OpenComs/docs/analog/devices/apsm1/electronics/BOM_OpenComs_APSM1_2023-05-12.csv

ID | Name | Designator | Footprint | Quantity | Manufacturer Part | Manufacturer | Supplier | Supplier Part | Price
1 | 10u | C30 | C1206 | 1 | CL31A106KBHNNNE | SAMSUNG(三星) | LCSC | C13585 | 0.032
2 | 24V_IN | P1 | CONN-TH_2P-P5.00 | 1 |  |  | LCSC
3 | POWER_SWITCH | P2 | CONN-TH_2P-P5.00 | 1 |  |  | LCSC
4 | 24V_LED | P3 | CONN-TH_2P-P5.00 | 1 |  |  | LCSC
5 | 24V | P4 | CONN-TH_2P-P5.00 | 1 |  |  | LCSC
6 | PL1 | P5 | CONN-TH_3P-P5.00 | 1 |  |  | LCSC
7 | PL2 | P6 | CONN-TH_3P-P5.00 | 1 |  |  | LCSC
8 | TERMINATE_SWITCH | P7 | CONN-TH_2P-P5.00 | 1 |  |  | LCSC
9 | 2.2k | R45 | R0805 | 1 | 0805W8F2201T5E | UNI-ROYAL(厚声) | LCSC | C17520 | 0.002
10 | 200 | R46 | R0805 | 1 | 0805W8F2000T5E | UNI-ROYAL(厚声) | LCSC | C17540 | 0.002
