OpenComs/docs/analog/devices/abp1/electronics/back_panel_jacks/BOM_OpenComs_ABP1_Back-panel_Jacks_2023-05-12.csv

ID | Name | Designator | Footprint | Quantity | Manufacturer Part | Manufacturer | Supplier | Supplier Part | Price
1 | FC68131 | 1,2 | FC68131-5P | 2
