OpenComs/docs/analog/devices/abp1/electronics/front_panel/BOM_OpenComs_ABP1_Front-panel_2023-05-12.csv

ID | Name | Designator | Footprint | Quantity | Manufacturer Part | Manufacturer | Supplier | Supplier Part | Price
1 | 1u | C1,C2,C3,C4,C5,C6,C7,C8 | C0805 | 8 | CL21B105KBFNNNE | SAMSUNG(三星) | LCSC | C28323 | 0.01
2 | WS2812B-4020 | LED1,LED2,LED3,LED4,LED5,LED6,LED7,LED8,LED9,LED10,LED11,LED12,LED13,LED14,LED15,LED16 | LED-SMD_WS2812B-4020 | 16 | WS2812B-4020 | worldsemi | LCSC | C965557 | 0.126
3 | TESTPAD50 | P5,P6,P7 | TESTPAD-50-ROUND | 3
4 | PS6KV50 | RP1 | PS6_POTMETER | 1 | PS6KV50-103A3030-I-PM | PIHER | TME | PS6KV50-103A-I-PM
