OpenComs/docs/analog/devices/abp1/electronics/main_pcb/BOM_OpenComs_ABP1_2023-05-12.csv

ID | Name | Designator | Footprint | Quantity | Manufacturer Part | Manufacturer | Supplier | Supplier Part | Price
1 | 22p | C1,C2 | C0603 | 2 | CL10C220JB8NNNC | SAMSUNG(三星) | LCSC | C1653 | 0.007
2 | 100p | C3 | C0805 | 1 | CL21C101JBANNNC | SAMSUNG(三星) | LCSC | C1790 | 0.01
3 | 820p | C4,C17 | C1206 | 2 | 1206B102K202NT | FH(风华) | LCSC | C9196 | 0.005
4 | 0.47u | C5,C25 | C0805 | 2 | CL21B474KBFNNNE | SAMSUNG(三星) | LCSC | C13967 | 0.014
5 | 1u | C8,C9,C31 | C0603 | 3 | CL10A105KB8NNNC | SAMSUNG(三星) | LCSC | C15849 | 0.005
6 | 100uF | C10 | CAP-SMD_BD8.0-L8.3-W8.3-FD | 1 | RVT1H101M0810 | HONOR(荣誉) | LCSC | C3352 | 0.096
7 | 10uF | C11,C12 | CAP-SMD_L3.2-W1.6-RD-C7171 | 2 | TAJA106K016RNJ | Kyocera AVX | LCSC | C7171 | 0.088
8 | 1u | C14,C19,C28 | C1206 | 3 | CL31B105KBHNNNE | SAMSUNG(三星) | LCSC | C1848 | 0.029
9 | 0.022u | C15,C29 | C0805 | 2 | CL21B223KBANNNC | SAMSUNG(三星) | LCSC | C1729 | 0.01
10 | 0.0047u | C16 | C0805 | 1 | 0805B472K500NT | FH(风华) | LCSC | C1744 | 0.005
11 | 4.7u | C18 | C1206 | 1 | CL21A475KAQNNNE | SAMSUNG(三星) | LCSC | C1779 | 0.011
12 | 0.0022u | C20 | C1206 | 1 | CL21C222JBFNNNE | SAMSUNG(三星) | LCSC | C28260 | 0.036
13 | 0.047u | C21,C23 | C0805 | 2 | CL21B473KBCNNNC | SAMSUNG(三星) | LCSC | C53134 | 0.012
14 | 56p | C22 | C0603 | 1 | CL10C560JB8NNNC | SAMSUNG(三星) | LCSC | C39148 | 0.009
15 | 150p | C24 | C0805 | 1 | 0805B151K500NT | FH(风华) | LCSC | C1716 | 0.005
16 | 39p | C26 | C0805 | 1 | CL21C470JBANNNC | SAMSUNG(三星) | LCSC | C14857 | 0.013
17 | 47u | C27 | C0805 | 1 | CL21A476MQYNNNE | SAMSUNG(三星) | LCSC | C16780 | 0.023
18 | 10u | C30 | C1206 | 1 | CL31A106KBHNNNE | SAMSUNG(三星) | LCSC | C13585 | 0.032
19 | 1N4148W | D1,D2,D4,D5 | SOD-123FL_L2.6-W1.6-LS3.4-RD | 4 | 1N4148W | Tak Cheong | LCSC | C129216 | 0.02
20 | SS210 | D3 | SMA_L4.3-W2.6-LS5.2-RD | 1 | SS210 | MDD | LCSC | C14996 | 0.026
21 | 68uH | L2 | IND-SMD_L6.0-W6.0_SWRH5D | 1 | YNR6028-680M | YJYCOIN(益嘉源) | LCSC | C497832 | 0.075
22 | FC-2012HRK-620D | LED1 | LED0805-RD_RED | 1 | NCD0805R1 | 国星光电 | LCSC | C84256 | 0.011
23 | 2N7002 | Q1 | SOT-23-3_L2.9-W1.3-P1.90-LS2.4-BR | 1 | 2N7002 | CJ(江苏长电/长晶) | LCSC | C8545 | 0.016
24 | SS8050 | Q2,Q4,Q6,Q7,Q9 | SOT-23-3_L2.9-W1.3-P1.90-LS2.4-BR | 5 | SS8050 | CJ(江苏长电/长晶) | LCSC | C2150 | 0.015
25 | MMBT5401 | Q3 | SOT-23-3_L2.9-W1.3-P1.90-LS2.4-BR | 1 | MMBT5401 | CJ(江苏长电/长晶) | LCSC | C8326 | 0.015
26 | 22 | R1,R25 | R1206 | 2 | 1206W4F220JT5E | UNI-ROYAL(厚声) | LCSC | C17958 | 0.003
27 | 220k | R2,R3,R8,R22 | R0805 | 4 | 0805W8F2203T5E | UNI-ROYAL(厚声) | LCSC | C17556 | 0.002
28 | 47k | R4,R16,R17,R20,R31 | R0805 | 5 | 0805W8F4702T5E | UNI-ROYAL(厚声) | LCSC | C17713 | 0.002
29 | 1k | R5,R36 | R1206 | 2 | 1206W4F1001T5E | UNI-ROYAL(厚声) | LCSC | C4410 | 0.003
30 | 15k | R6,R11,R21 | R0805 | 3 | 0805W8F1502T5E | UNI-ROYAL(厚声) | LCSC | C17475 | 0.002
31 | 100k | R7,R33 | R1206 | 2 | 1206W4F1003T5E | UNI-ROYAL(厚声) | LCSC | C17900 | 0.003
32 | 10k | R9,R34,R41,R43,R51 | R1206 | 5 | 1206W4F1002T5E | UNI-ROYAL(厚声) | LCSC | C17902 | 0.003
33 | 2.7k | R10,R29 | R0805 | 2 | 0805W8F2701T5E |  | LCSC
34 | 6.8k | R12 | R0805 | 1 | 0805W8F6801T5E | UNI-ROYAL(厚声) | LCSC | C17772 | 0.002
35 | 20k | R13,R14 | R0805 | 2 | 0805W8F2002T5E | UNI-ROYAL(厚声) | LCSC | C4328 | 0.001
36 | 430 | R15 | R0805 | 1 | 0805W8F4700T5E | UNI-ROYAL(厚声) | LCSC | C17710 | 0.002
37 | 2.2k | R18,R45 | R0805 | 2 | 0805W8F2201T5E | UNI-ROYAL(厚声) | LCSC | C17520 | 0.002
38 | 120k | R19 | R0805 | 1 | 0805W8F1203T5E | UNI-ROYAL(厚声) | LCSC | C17436 | 0.002
39 | 5.6k | R23 | R0805 | 1 | 0805W8F5601T5E | UNI-ROYAL(厚声) | LCSC | C4382 | 0.002
40 | 150k | R24 | R0805 | 1 | 0805W8F1503T5E | UNI-ROYAL(厚声) | LCSC | C17470 | 0.002
41 | 39 | R26 | R0805 | 1 | 0805W8F330JT5E | UNI-ROYAL(厚声) | LCSC | C17634 | 0.002
42 | 330k | R30,R38 | R0805 | 2 | 0805W8F3303T5E | UNI-ROYAL(厚声) | LCSC | C17629 | 0.002
43 | 4.7k | R32,R44,R47 | R1206 | 3 | 1206W4F4701T5E | UNI-ROYAL(厚声) | LCSC | C17936 | 0.003
44 | 470k | R35,R40 | R0805 | 2 | 0805W8F4703T5E | UNI-ROYAL(厚声) | LCSC | C17709 | 0.002
45 | 150 | R37 | R0805 | 1 | 0805W8F1500T5E | UNI-ROYAL(厚声) | LCSC | C17471 | 0.002
46 | 10M | R39 | R0805 | 1 | 0805W8F1005T5E | UNI-ROYAL(厚声) | LCSC | C26108 | 0.002
47 | 200 | R46 | R0805 | 1 | 0805W8F2000T5E | UNI-ROYAL(厚声) | LCSC | C17540 | 0.002
48 | XL1509-5.0E1 | U3 | SOIC-8_L5.0-W4.0-P1.27-LS6.0-BL | 1 | XL1509-5.0E1 | XLSEMI(芯龙) | LCSC | C61063 | 0.22
49 | ATMEGA328P-AU | U6 | TQFP-32_L7.0-W7.0-P0.80-LS9.0-BL | 1 | ATMEGA328P-AU | MICROCHIP(美国微芯) | LCSC | C14877 | 2.52
50 | 16MHz | X1 | OSC-SMD_4P-L3.2-W2.5-BL | 1 | X322516MLB4SI | YXC(扬兴晶振) | LCSC | C13738 | 0.076
51 | NE5532DR | U1,U2,U4,U5 | SOIC-8_L4.9-W3.9-P1.27-LS6.0-BL | 4 | NE5532DR | TI(德州仪器) | LCSC | C7426 | 0.267
