OpenComs/docs/analog/devices/aps1/3d/Assem1.SLDASM

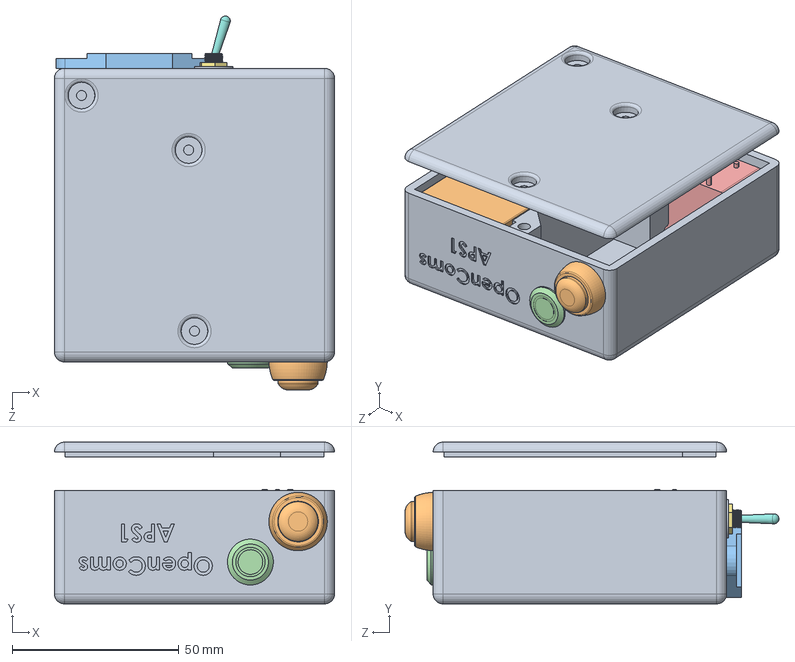
[picture p1: CAD file, 2023-05-15]
analog/devices/aps1/3d/Assem1.SLDASM
84.0 x 48.5 x 112.1 mm
base
Hi-Link HiLink HLK-PM
IEC-C4-3pins
FlatButton
3-D NC3MAH.stp
toggle_mts_1_base_thread
toggle_mts_1_nut
toggle_mts_1_lever
toggle_mts_1_washer
Button PBS-33^Push Button Switch PBS-33B - blue
Nut^Push Button Switch PBS-33B - blue
