OpenComs/docs/analog/devices/abp1/3d/back_panel.SLDASM

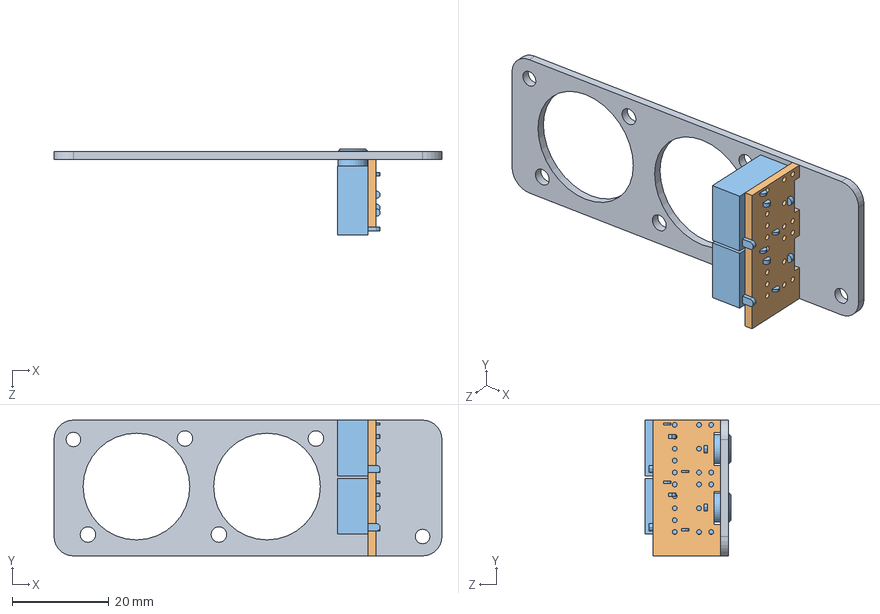
[picture p2: CAD file, 2023-05-15]
analog/devices/abp1/3d/back_panel.SLDASM
80.0 x 28.0 x 17.7 mm
back_panel_pcb
back_panel_jack_pcb
Jack 3_5 mm TRS femaile x 2
