OpenComs/docs/analog/devices/abp1/3d/front_panel.SLDASM

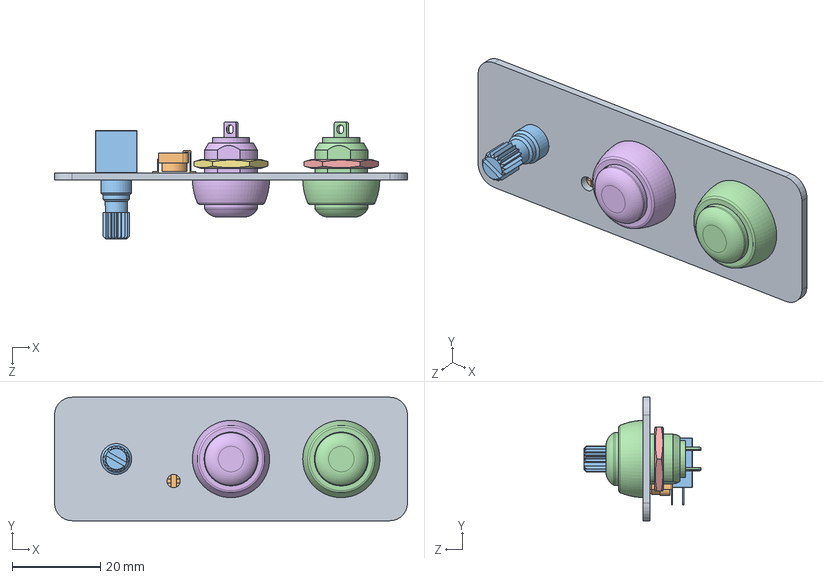
[picture p3: CAD file, 2023-05-15]
analog/devices/abp1/3d/front_panel.SLDASM
80.0 x 28.0 x 26.6 mm
front_panel_pcb
Pot - RES_VAR1
PTD902-2015F-A103
Button PBS-33^Push Button Switch PBS-33B - red
Nut^Push Button Switch PBS-33B - red
Button PBS-33^Push Button Switch PBS-33B - green
Nut^Push Button Switch PBS-33B - green
