OpenComs/docs/analog/devices/abp1/3d/pcb_assembly.SLDASM

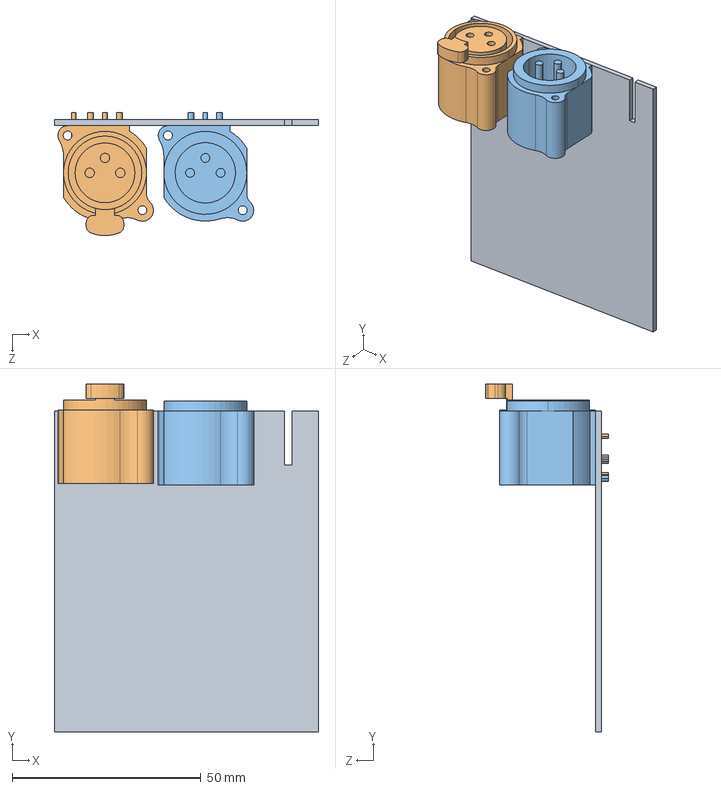
[picture p4: CAD file, 2023-05-15]
analog/devices/abp1/3d/pcb_assembly.SLDASM
70.0 x 92.2 x 32.6 mm
pcb
3-d-nc3faah2.stp
3-D NC3MAH.stp
