OpenComs/docs/analog/devices/abp1/3d/assembly.SLDASM

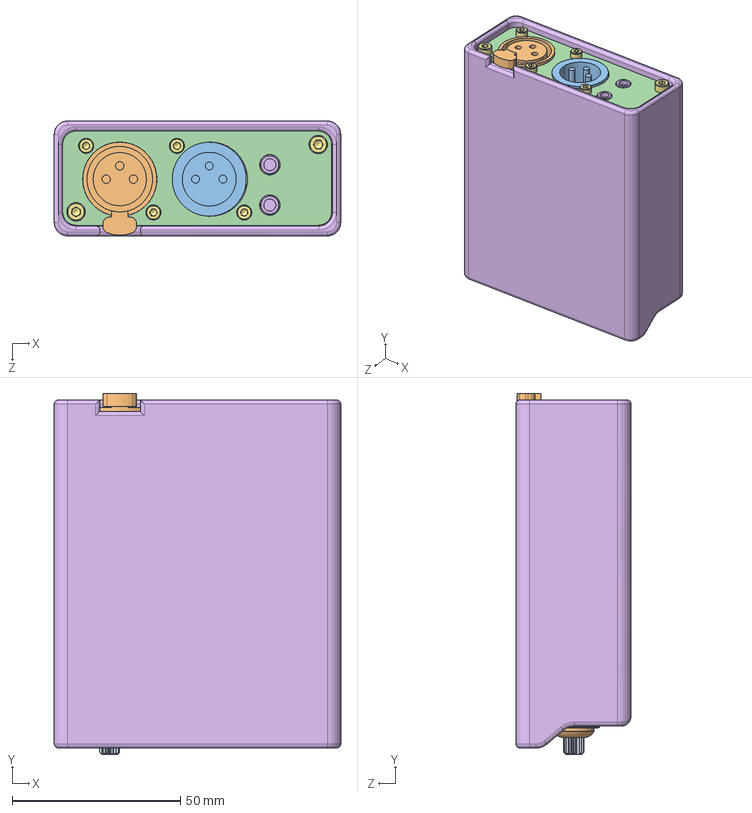
[picture p5: CAD file, 2023-05-15]
analog/devices/abp1/3d/assembly.SLDASM
85.2 x 107.3 x 34.2 mm
pcb
3-d-nc3faah2.stp
3-D NC3MAH.stp
back_panel_pcb
back_panel_jack_pcb
Jack 3_5 mm TRS femaile x 2
front_panel_pcb
Pot - RES_VAR1
PTD902-2015F-A103
Button PBS-33^Push Button Switch PBS-33B - red
Nut^Push Button Switch PBS-33B - red
Button PBS-33^Push Button Switch PBS-33B - green
Nut^Push Button Switch PBS-33B - green
case
socket head cap screw_am x 6
