OpenComs/docs/analog/devices/abp1/3d/back_panel_pcb.SLDPRT

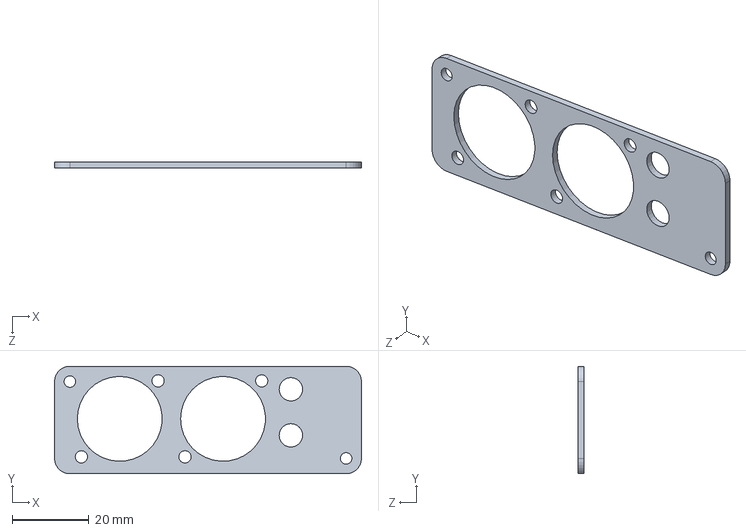
[picture p6: CAD file, 2023-05-15]
analog/devices/abp1/3d/back_panel_pcb.SLDPRT
80.0 x 28.0 x 1.60 mm
