OpenComs/docs/analog/devices/aps1/3d/case.SLDPRT

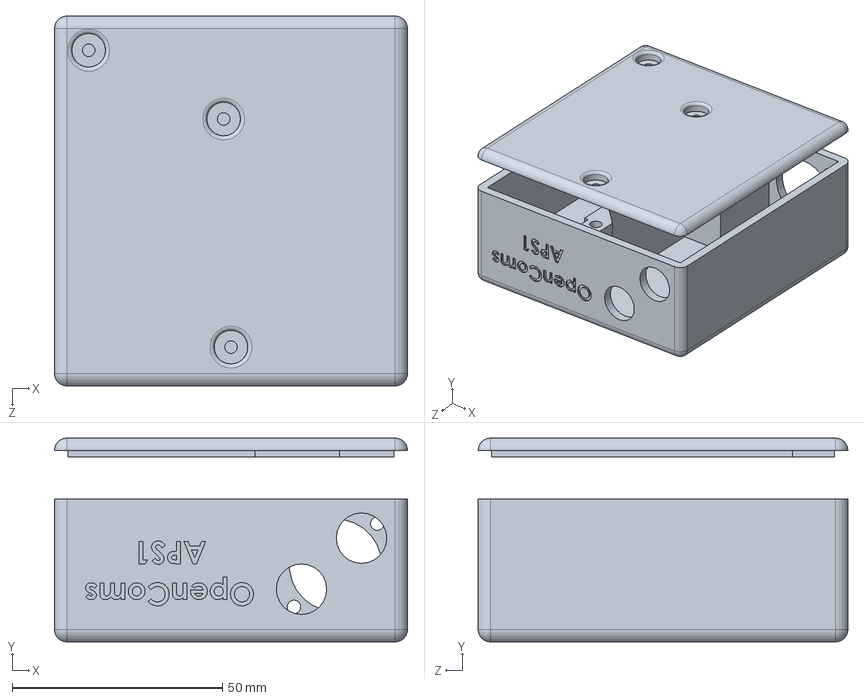
[picture p7: CAD file, 2023-05-15]
analog/devices/aps1/3d/case.SLDPRT
84.0 x 48.5 x 88.0 mm
