OpenComs/docs/analog/devices/abp1/3d/pcb.SLDPRT

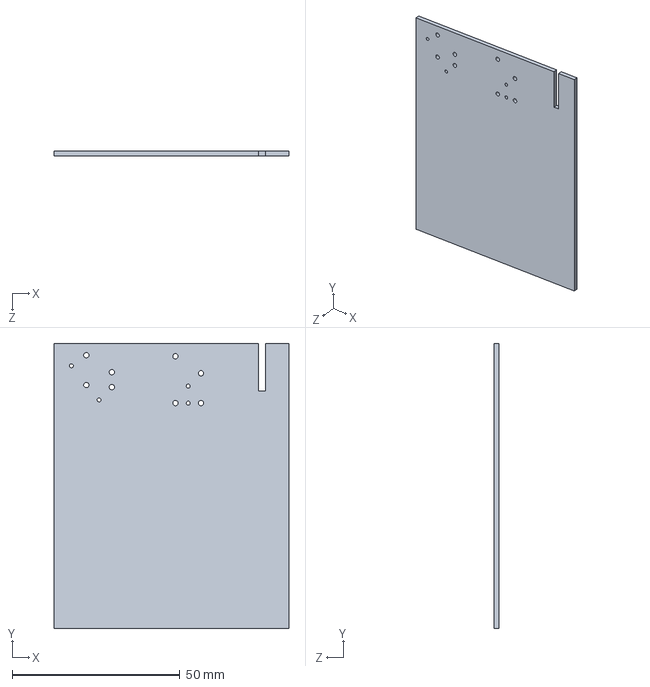
[picture p8: CAD file, 2023-05-15]
analog/devices/abp1/3d/pcb.SLDPRT
70.0 x 85.0 x 1.60 mm
