OpenComs/docs/analog/devices/aps1/3d/case_cover.STL

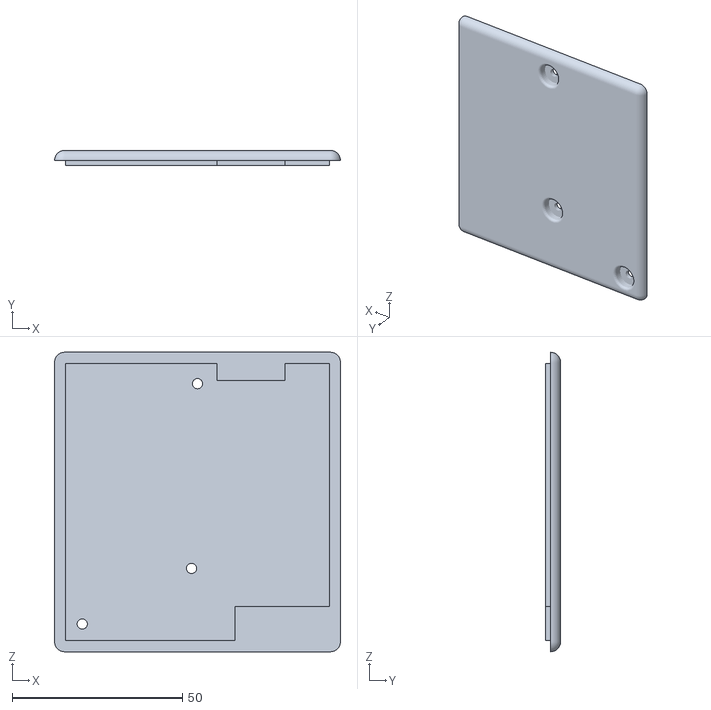
[picture p9: CAD file, 2023-05-15]
analog/devices/aps1/3d/case_cover.STL
84.0 x 4.50 x 88.0
