OpenComs/docs/analog/devices/abp1/3d/case.SLDPRT

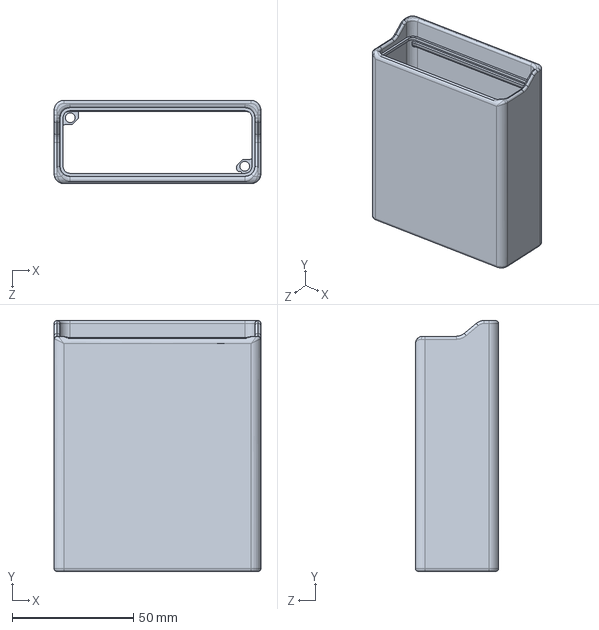
[picture p11: CAD file, 2023-05-15]
analog/devices/abp1/3d/case.SLDPRT
85.3 x 103.5 x 34.3 mm
