OpenComs/docs/analog/devices/abp1/3d/back_panel_jack_pcb.SLDPRT

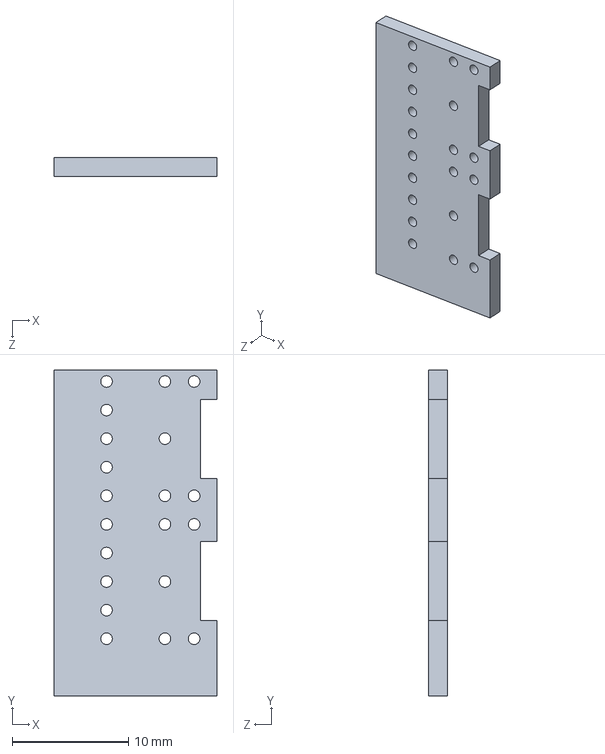
[picture p12: CAD file, 2023-05-15]
analog/devices/abp1/3d/back_panel_jack_pcb.SLDPRT
14.0 x 28.0 x 1.60 mm
