OpenComs/docs/(list of files, cad)

Other CAD files:
analog/devices/abp1/3d/case.STL
analog/devices/aps1/3d/case.STL
