OpenComs/docs/analog/devices/apsm1/electronics/SCH_PDF_OpenComs_APSM1_2023-05-12.pdf

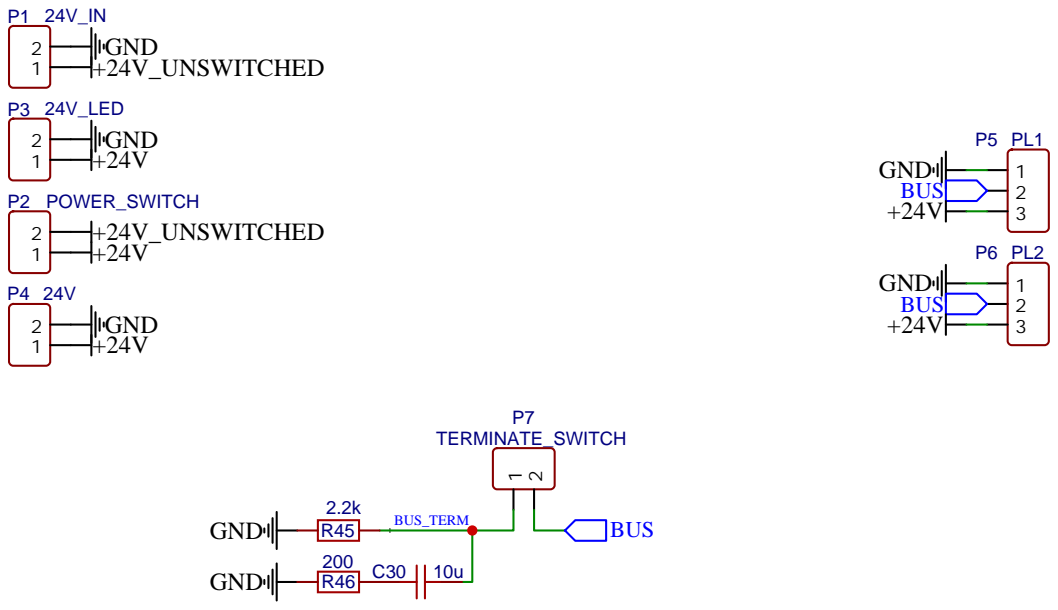
[picture p13: page 1]
