OpenComs/docs/analog/devices/abp1/electronics/back_panel_jacks/SCH_PDF_OpenComs_ABP1_Back-panel_Jacks_2023-05-12.pdf

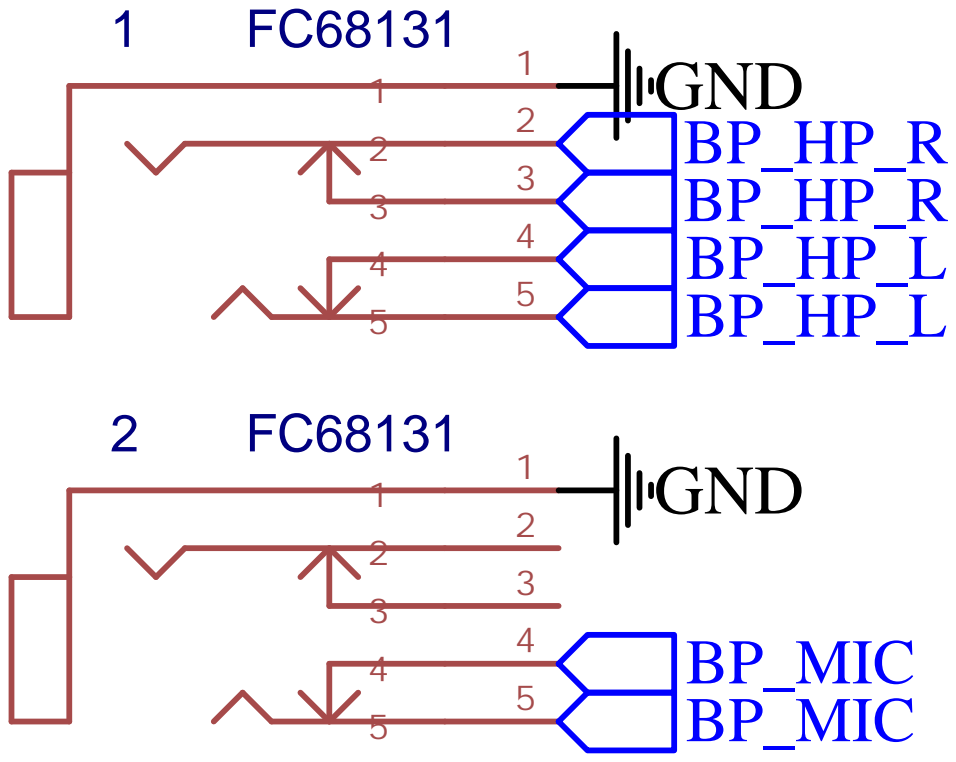
[picture p14: page 1]
