OpenComs/docs/analog/devices/abp1/electronics/front_panel/SCH_PDF_OpenComs_ABP1_Front-panel.pdf

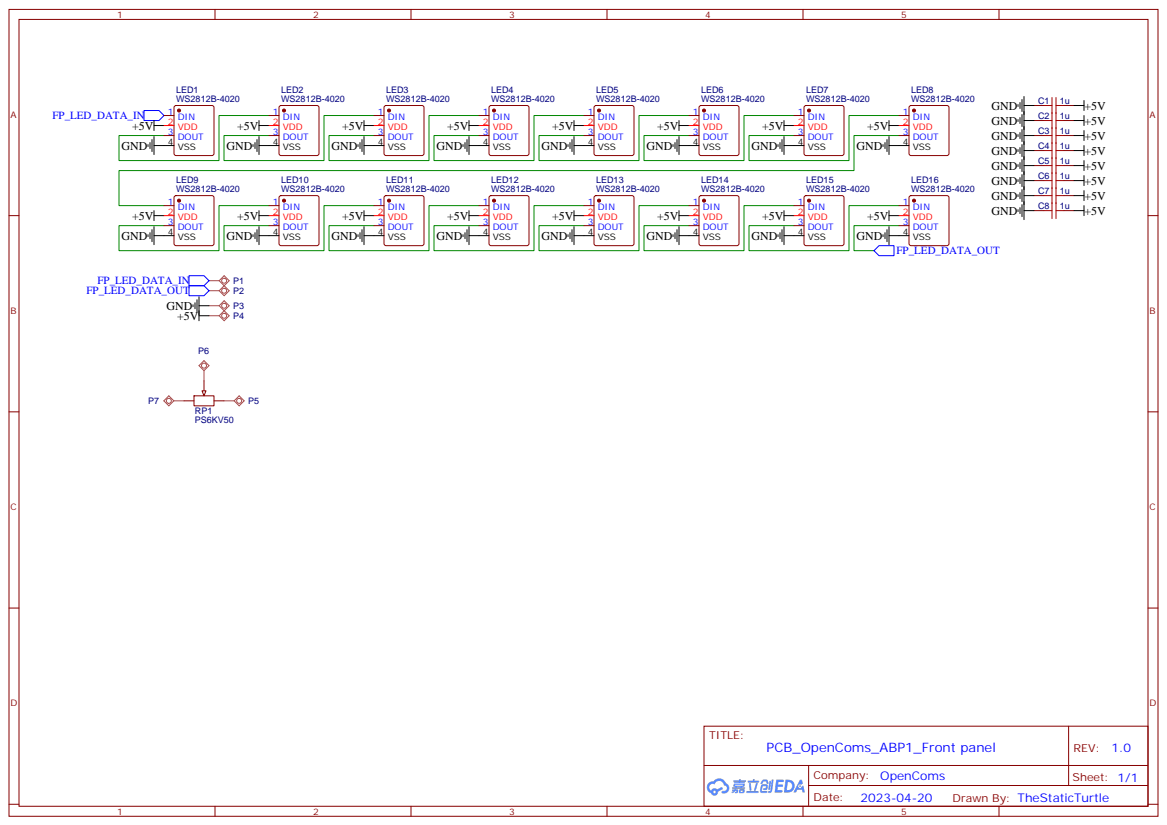
[picture p15: page 1]
