OpenComs/docs/analog/devices/abp1/electronics/main_pcb/SCH_OpenComs_ABP1_2023-05-12.pdf

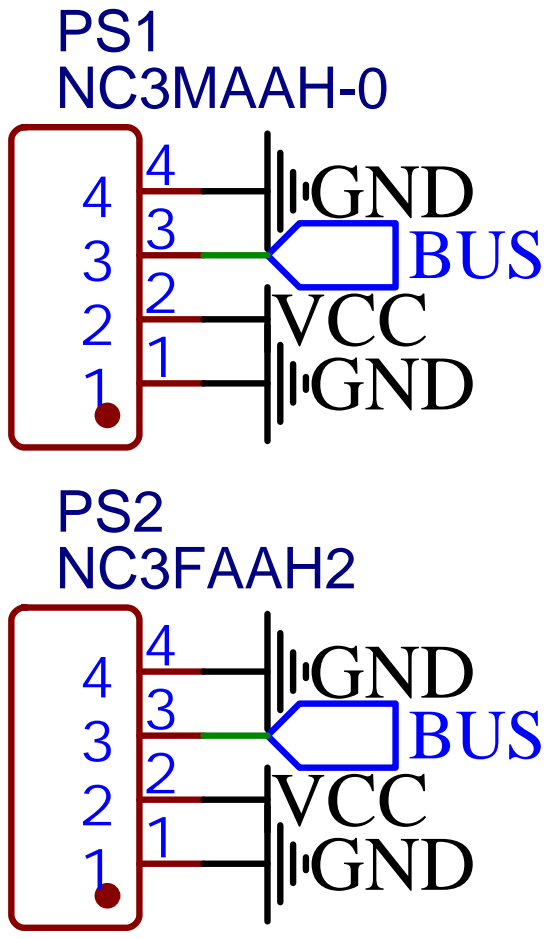
[picture p16: page 1]

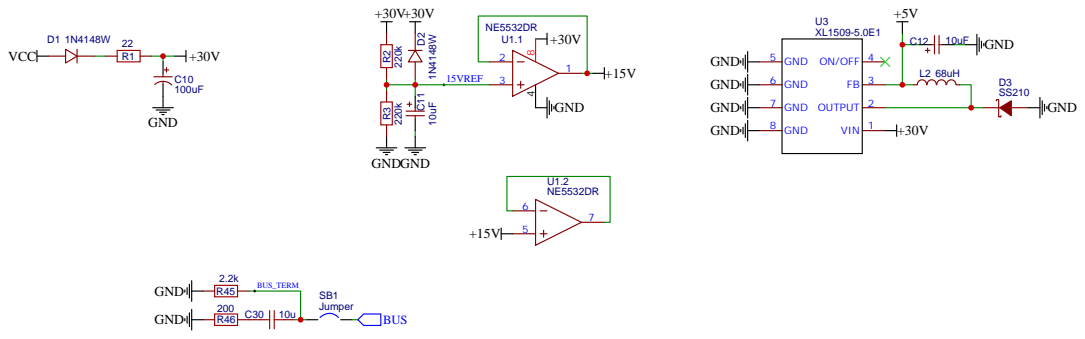
[picture p17: page 2]

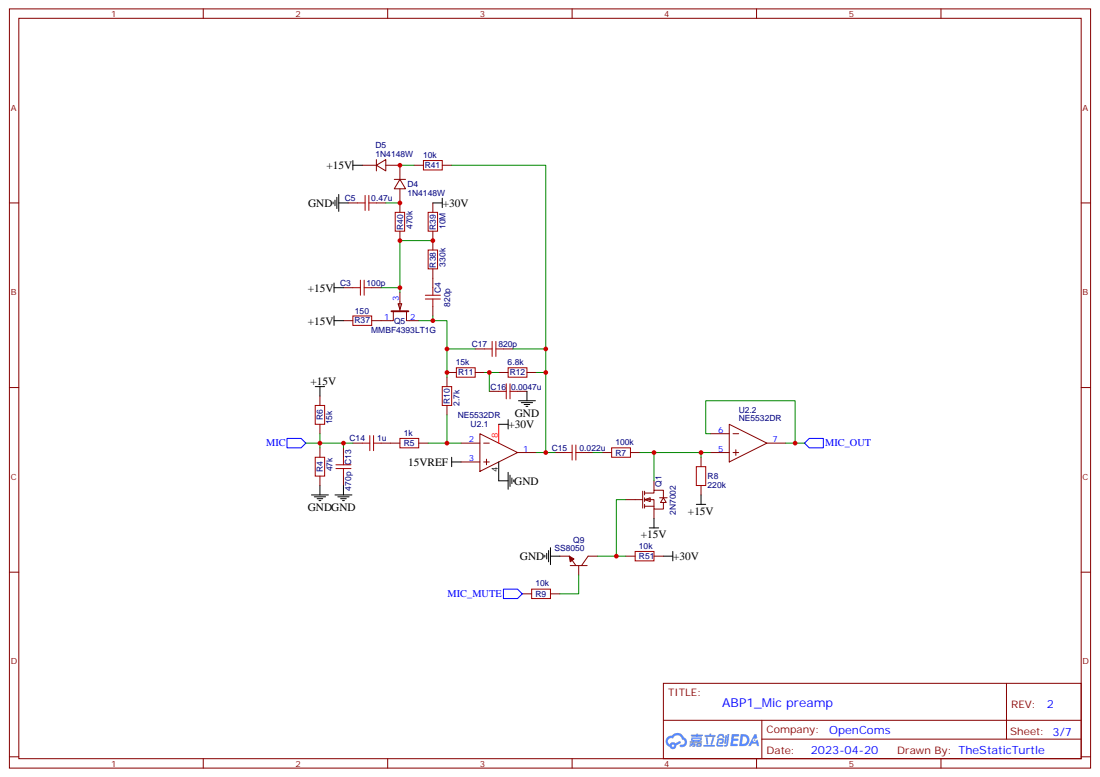
[picture p18: page 3]

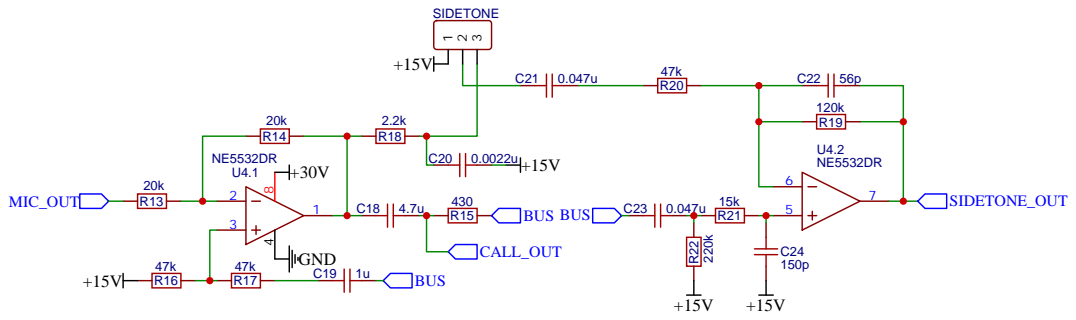
[picture p19: page 4]

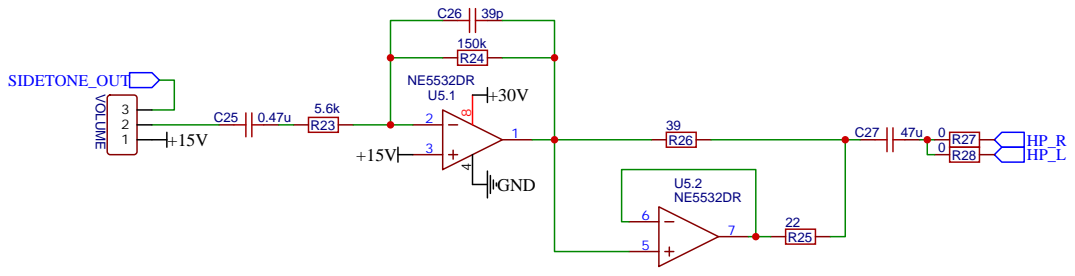
[picture p20: page 5]

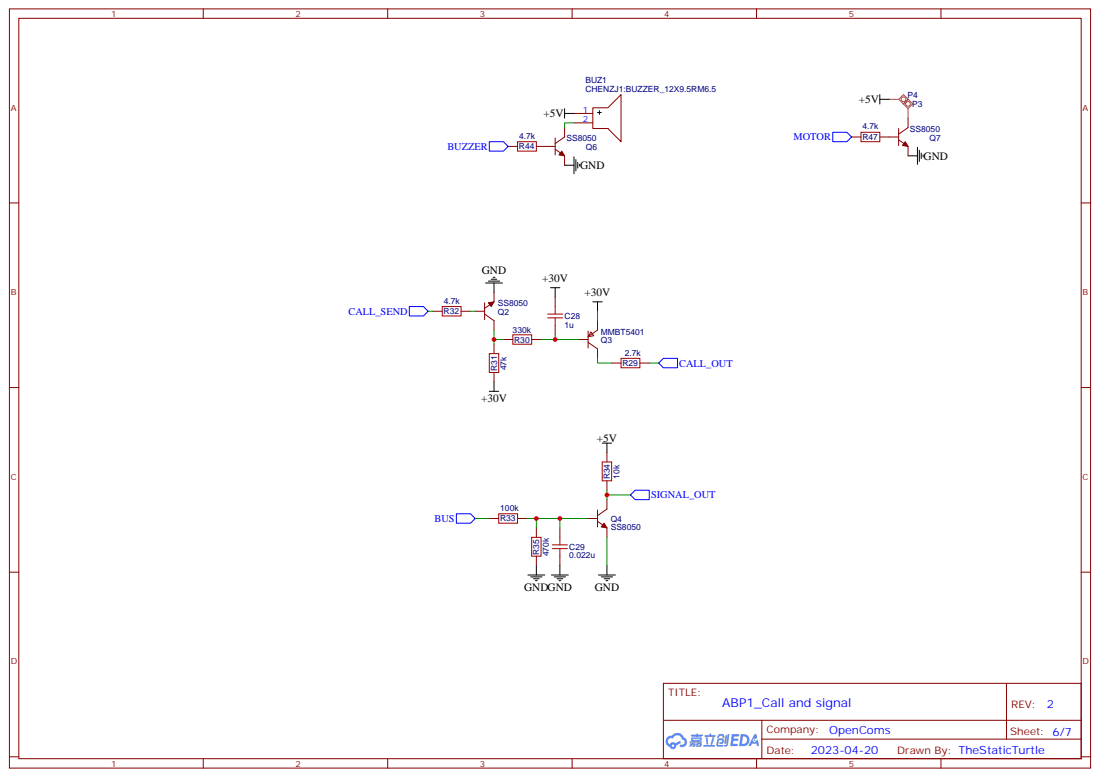
[picture p21: page 6]

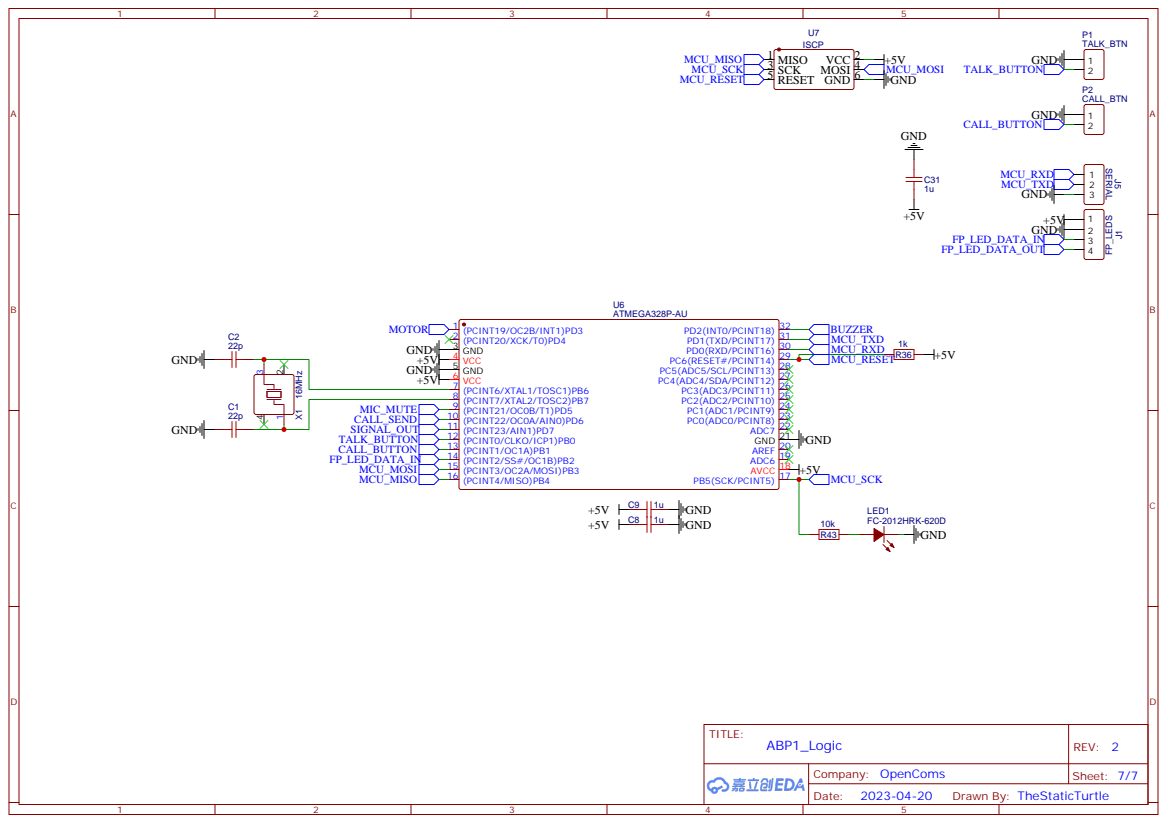
[picture p22: page 7]
