OpenComs/docs/(list of files, drawings)

Other design files:
analog/devices/abp1/electronics/back_panel/PCB_Altium_OpenComs_ABP1_Back-panel_2023-05-12.pcbdoc
analog/devices/abp1/electronics/back_panel/PCB_EasyEDA_OpenComs_ABP1_Back-panel_2023-05-12.json
analog/devices/abp1/electronics/back_panel_jacks/PCB_Altium_OpenComs_ABP1_Back-panel_Jacks_2023-05-12.pcbdoc
analog/devices/abp1/electronics/back_panel_jacks/PCB_EasyEDA_OpenComs_ABP1_Back-panel_Jacks_2023-05-12.json
analog/devices/abp1/electronics/back_panel_jacks/SCH_Altium_OpenComs_ABP1_Back-panel_Jacks_Connectors_2023-05-12.schdoc
analog/devices/abp1/electronics/back_panel_jacks/SCH_EasyEDA_OpenComs_ABP1_Back-panel_Jacks_2023-05-12.json
analog/devices/abp1/electronics/front_panel/PCB_Altium_OpenComs_ABP1_Front-panel_2023-05-12.pcbdoc
analog/devices/abp1/electronics/front_panel/PCB_EasyEDA_OpenComs_ABP1_Front-panel_2023-05-12.json
analog/devices/abp1/electronics/front_panel/SCH_Altium_OpenComs_ABP1_Front-panel_.schdoc
analog/devices/abp1/electronics/front_panel/SCH_EasyEDA_OpenComs_ABP1_Front-panel_2023-05-12.json
analog/devices/abp1/electronics/main_pcb/PCB_AltiumExport_OpenComs_ABP1_2023-05-12.pcbdoc
analog/devices/abp1/electronics/main_pcb/PCB_EasyEDA_OpenComs_ABP1_2023-05-12.json
analog/devices/abp1/electronics/main_pcb/SCH_EasyEDA_OpenComs_ABP1_2023-05-12.json
analog/devices/apsm1/electronics/PCB_Altium_OpenComs_APSM1_2023-05-12.pcbdoc
analog/devices/apsm1/electronics/PCB_EasyEDA_OpenComs_APSM1_2023-05-12.json
analog/devices/apsm1/electronics/SCH_Altium_OpenComs_APSM1_2023-05-12.schdoc
analog/devices/apsm1/electronics/SCH_EasyEDA_OpenComs_APSM1_2023-05-12.json
